waynegramlich/dual_slot_encoders/README.md

# dual_slot_encoders

Quadrature encoder using two slot photointerrupters

## Revision A Issues

* The footprint holes for the slot encoders are too small. [x]

## Revision B Issues

* Use a 2x4 ribbon cable for both encoder signals and motor power.

## Revision D Issues

* Pins 4/5 and 6/7 are swapped in bus_bridge_encoders_sonar (Rev. C)
  and dual_slot_encoders (Rev. D). [Swapped 4/5 and 6/7.]

## Revision E Issuses

* Both resistors are too close to the edge.
