waynegramlich/dual_slot_encoders/rev_f/dual_slot_encoders.pdf

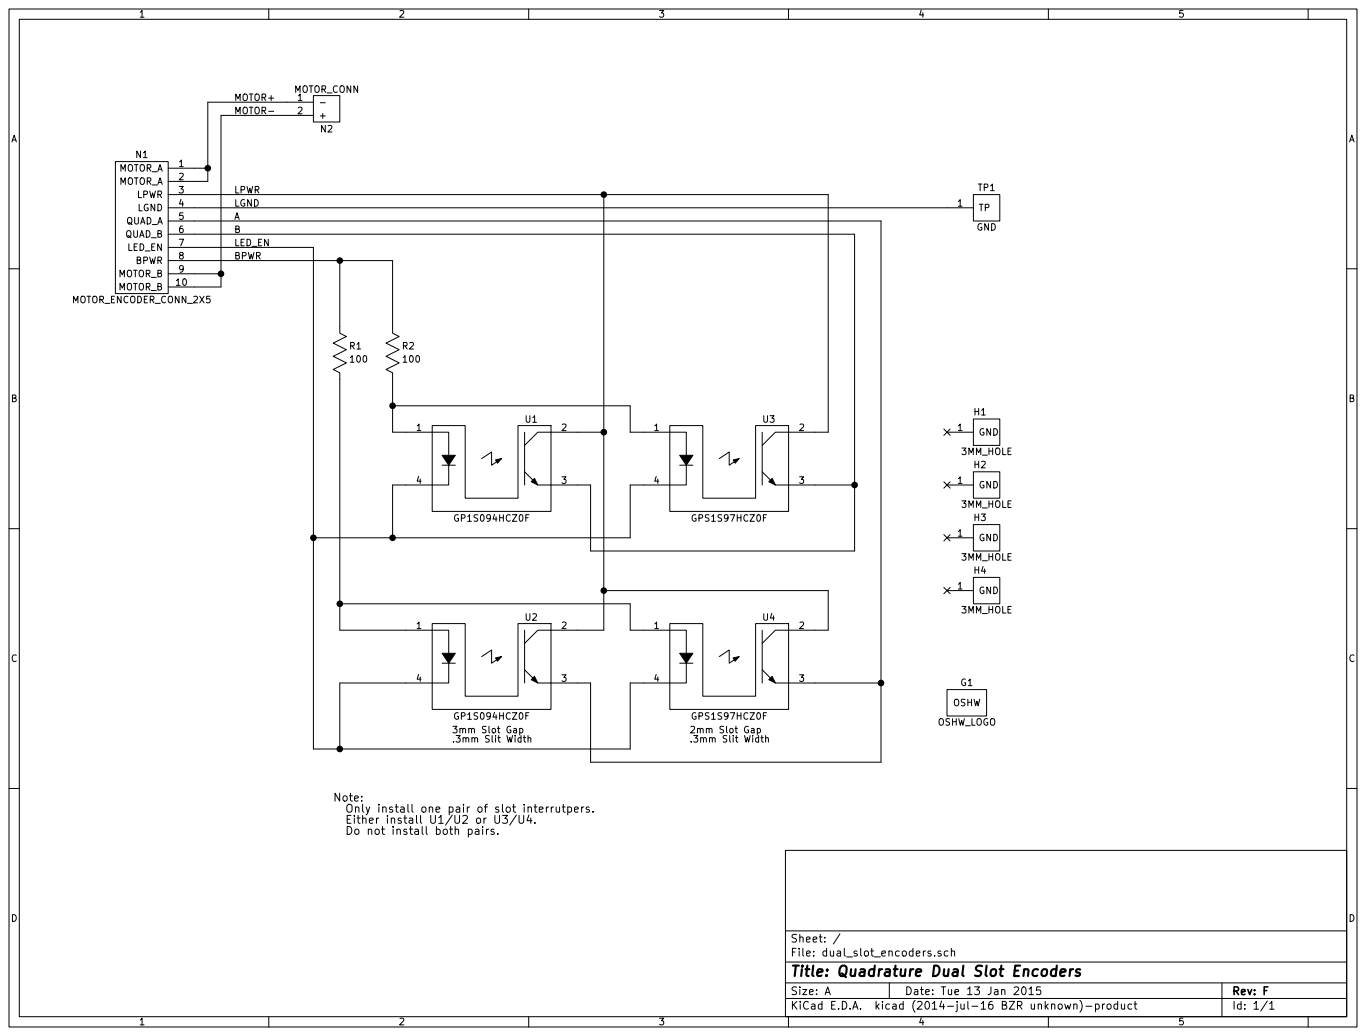
[picture p1: page 1]

LED_EN
BPWR

Only install one pair of slot interrutpers.
Either install U1/U2 or U3/U4.
Do not install both pairs.

File: dual_slot_encoders.sch Sheet: /
Id: 1/1 Title: Quadrature Dual Slot Encoders
