waynegramlich/dual_slot_encoders/rev_f/dual_slot_encoders.kicad_pcb

## KiCad design rev_f/dual_slot_encoders.kicad_pcb (2015-01-13)

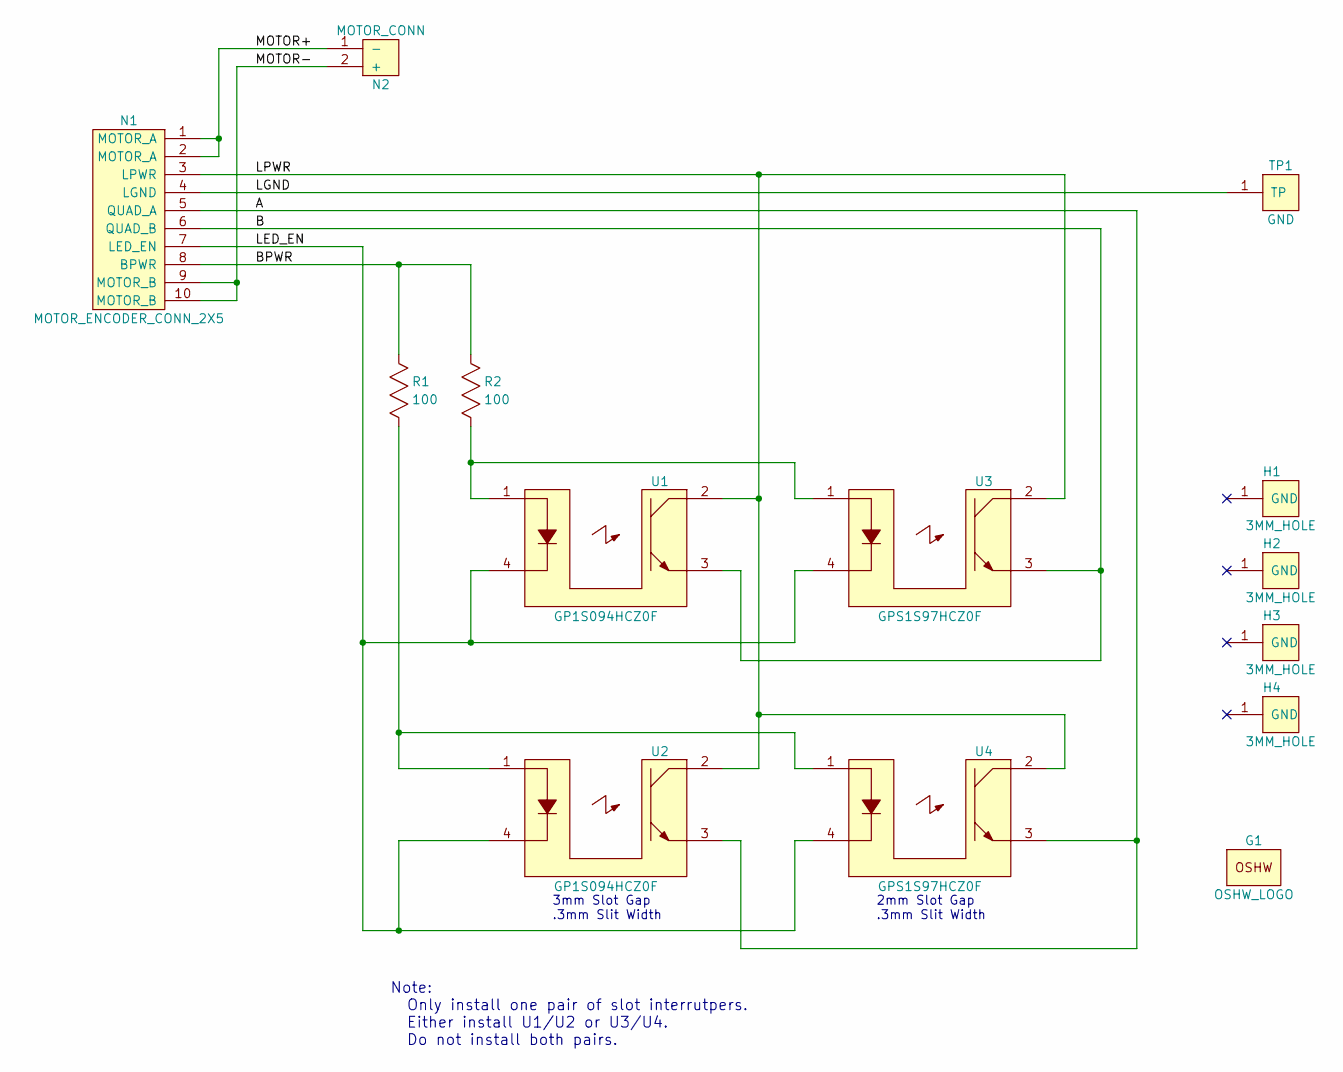
[picture p2: schematic dual_slot_encoders.sch, Quadrature Dual Slot Encoders]

Parts:
G1: OSHW_LOGO; OSHW_LOGO_200mil
H1, H2, H3, H4: 3MM_HOLE; MountingHole_3mm
N1: MOTOR_ENCODER_CONN_2X5; Pin_Header_Straight_2x05_Shrouded
N2: MOTOR_CONN; 5MM_TERMINAL_BLOCK_2_POS
R1, R2: 100; Resistor_Horizontal_400
TP1: GND; Pin_Header_Straight_1x01
U1, U2: GP1S094HCZ0F
U3, U4: GPS1S97HCZ0F; GP1S097HCZ0F

Connections:
/A: N1.5 (QUAD_A), U2.3, U4.3
/B: N1.6 (QUAD_B), U1.3, U3.3
/BPWR: N1.8 (BPWR), R1.2, R2.2
/LED_EN: N1.7 (LED_EN), U1.4, U2.4, U3.4, U4.4
/LGND: N1.4 (LGND), TP1.1
/LPWR: N1.3 (LPWR), U1.2, U2.2, U3.2, U4.2
/MOTOR+: N1.1 (MOTOR_A), N1.2 (MOTOR_A), N2.1 (-)
/MOTOR-: N1.9 (MOTOR_B), N1.10 (MOTOR_B), N2.2 (+)
unnamed: R1.1, U2.1, U4.1
unnamed: R2.1, U1.1, U3.1

Notes on the sheet:
3mm Slot Gap .3mm Slit Width
2mm Slot Gap .3mm Slit Width
Note: Only install one pair of slot interrutpers. Either install U1/U2 or U3/U4. Do not install both pairs.

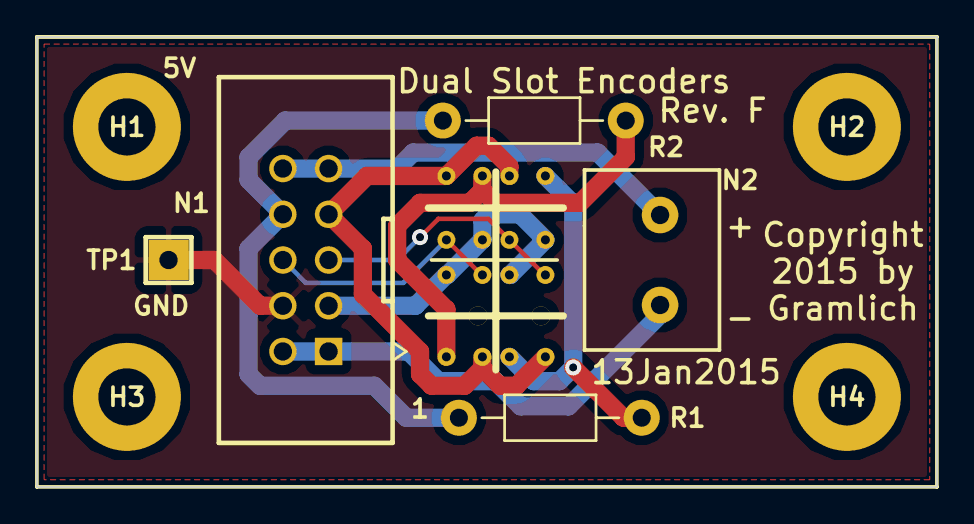
[picture p3: board dual_slot_encoders.kicad_pcb from above]

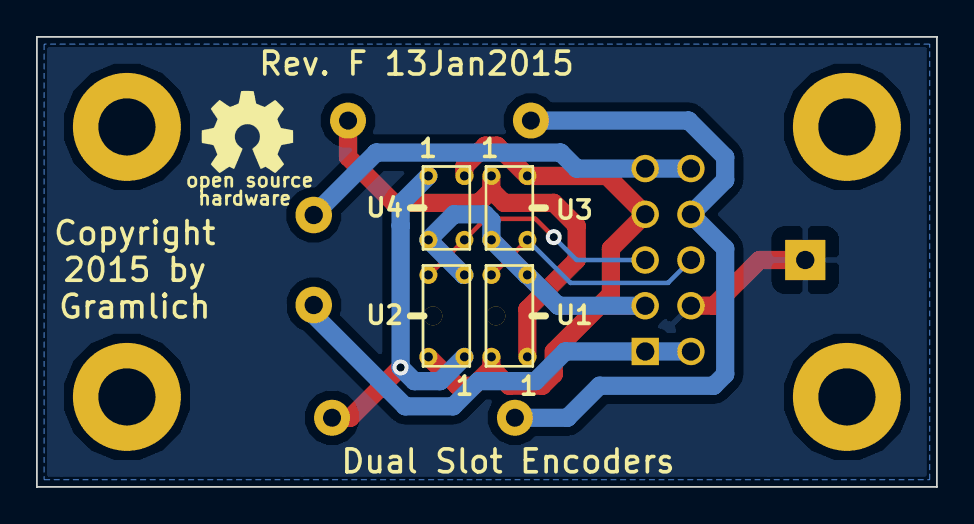
[picture p4: board dual_slot_encoders.kicad_pcb from below]

Board: 2 copper layers, 50.0 x 25.0 mm, 14 parts (5 on the bottom side), 10 nets.
