waynegramlich/dual_slot_encoders/(commit log)

2014-07-13 Got PCB layed out.
    [dual_slot_encoders.kicad_pcb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]
2014-07-13 Added edge cuts.
    [dual_slot_encoders-B_Cu.gbl, dual_slot_encoders-B_Mask.gbs, dual_slot_encoders-B_SilkS.gbo, dual_slot_encoders-Edge_Cuts.gbr, dual_slot_encoders-F_Cu.gtl, dual_slot_encoders-F_Mask.gts, dual_slot_encoders-F_SilkS.gto, dual_slot_encoders.drl]
2014-07-28 Made a clone of Rev. A
    [dual_slot_encoders.kicad_pcb, dual_slot_encoders.sch]
2014-07-29 Fixed interrupter lead holes.
    [dual_slot_encoders-B_Cu.gbl, dual_slot_encoders-B_Mask.gbs, dual_slot_encoders-B_SilkS.gbo, dual_slot_encoders-Edge_Cuts.gbr, dual_slot_encoders-F_Cu.gtl, dual_slot_encoders-F_Mask.gts, dual_slot_encoders-F_SilkS.gto, dual_slot_encoders.drl]
2014-10-05 Switch Rev. B to use local fp-lib-table.
2014-10-05 Cloned Rev. C from Rev. B
    [dual_slot_encoders.kicad_pcb, dual_slot_encoders.sch]
2014-10-05 Rev. C is pretty much done.
    [dual_slot_encoders-B_Cu.gbl, dual_slot_encoders-B_Mask.gbs, dual_slot_encoders-B_SilkS.gbo, dual_slot_encoders-Edge_Cuts.gbr, dual_slot_encoders-F_Cu.gtl, dual_slot_encoders-F_Mask.gts, dual_slot_encoders-F_SilkS.gto, dual_slot_encoders.drl]
2014-10-11 Rev. C should be done.
    [dual_slot_encoders-B_Cu.gbl, dual_slot_encoders-B_Mask.gbs, dual_slot_encoders-B_SilkS.gbo, dual_slot_encoders-Edge_Cuts.gbr, dual_slot_encoders-F_Cu.gtl, dual_slot_encoders-F_Mask.gts, dual_slot_encoders-F_SilkS.gto, dual_slot_encoders.drl]
2014-10-11 Cloned Rev. C to produce Rev.D
    [dual_slot_encoders.kicad_pcb, dual_slot_encoders.sch]
2014-10-11 Rev. D is pretty much ready.
    [dual_slot_encoders-B_Cu.gbl, dual_slot_encoders-B_Mask.gbs, dual_slot_encoders-B_SilkS.gbo, dual_slot_encoders-Edge_Cuts.gbr, dual_slot_encoders-F_Cu.gtl, dual_slot_encoders-F_Mask.gts, dual_slot_encoders-F_SilkS.gto, dual_slot_encoders.drl]
2014-10-30 Clone Rev. D to Rev. E
    [dual_slot_encoders.kicad_pcb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]
2014-10-30 Got Rev. E wrapped up.
    [dual_slot_encoders-B_Cu.gbl, dual_slot_encoders-B_Mask.gbs, dual_slot_encoders-B_SilkS.gbo, dual_slot_encoders-Edge_Cuts.gbr, dual_slot_encoders-F_Cu.gtl, dual_slot_encoders-F_Mask.gts, dual_slot_encoders-F_SilkS.gto, dual_slot_encoders.drl]
2015-01-13 Revision F is ready for manufacture.
    [dual_slot_encoders-B_Cu.gbl, dual_slot_encoders-B_Mask.gbs, dual_slot_encoders-B_SilkS.gbo, dual_slot_encoders-Edge_Cuts.gbr, dual_slot_encoders-F_Cu.gtl, dual_slot_encoders-F_Mask.gts, dual_slot_encoders-F_SilkS.gto, dual_slot_encoders.drl]
